adamgreig/rigchip/README.md

# rigchip

connects your CHIP to your RIG

runs off rig 12V, audio in/out, serial in/out, PTT/SQL in/out

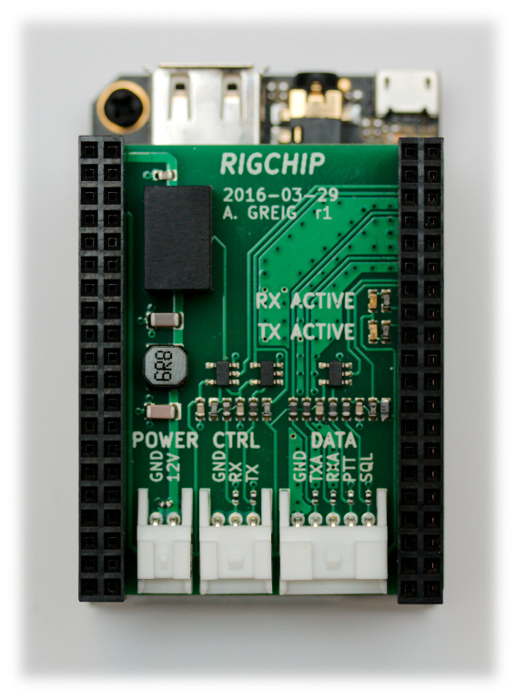
[picture p1: rigchip.jpg]
rigchip glamor shot

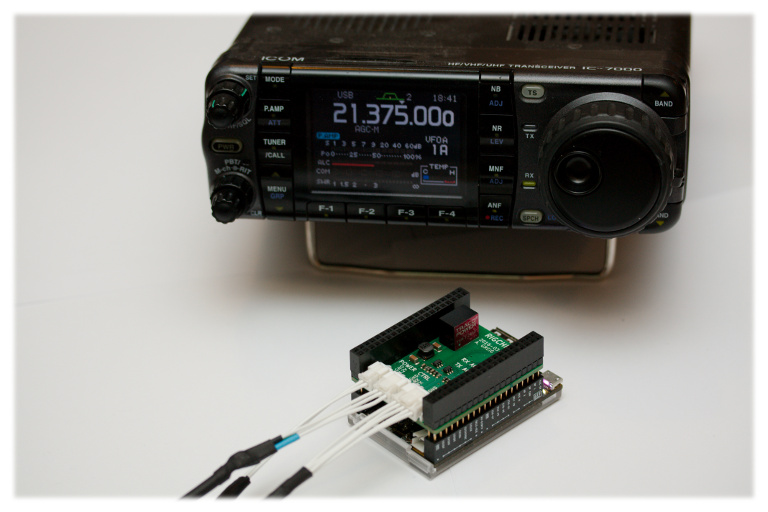
[picture p2: rigchip_with_rig.jpg]
rigchip with rig
