adamgreig/rigchip/pcb/rigchip.png

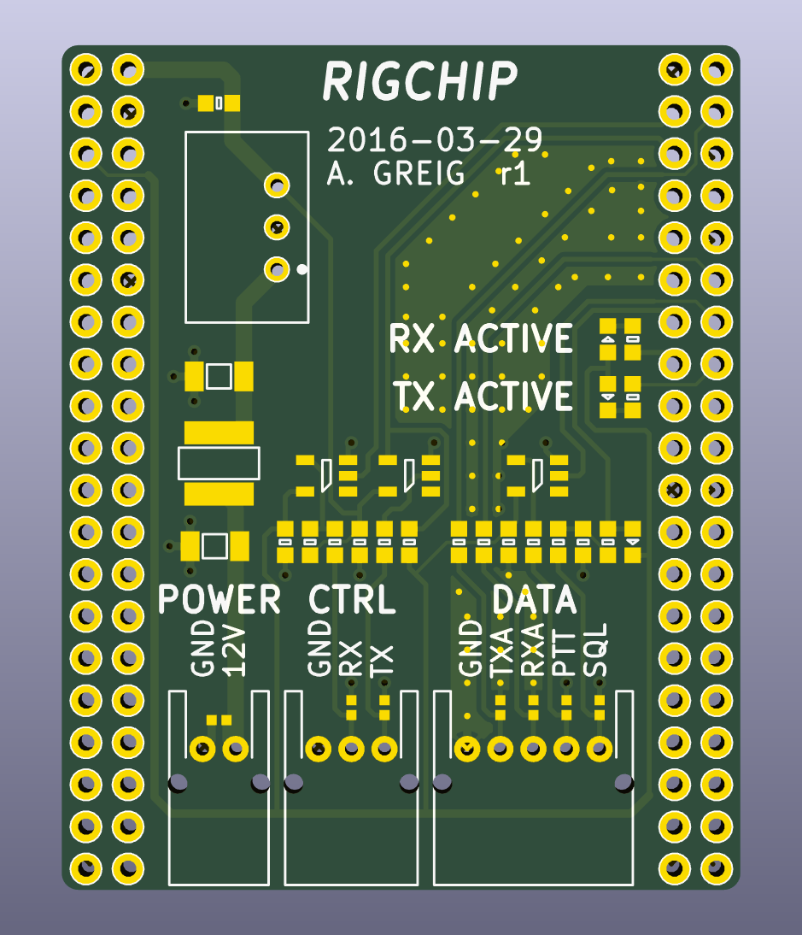
pcb/rigchip.png
