adamgreig/rigchip/pcb/rigchip_bom.pdf

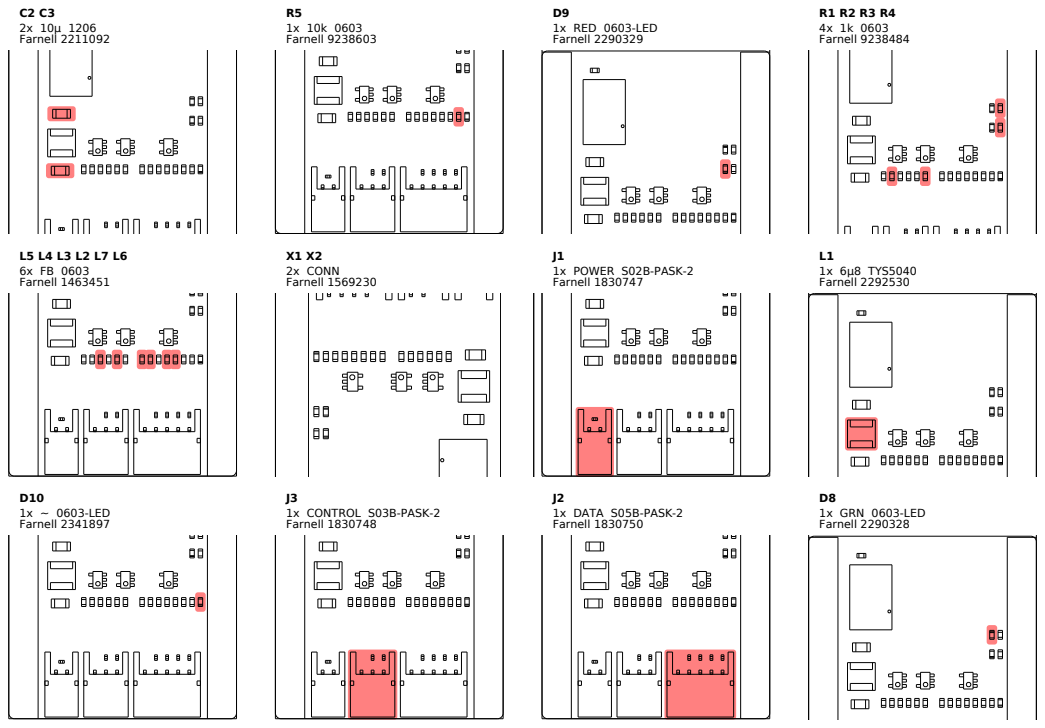
[picture p4: page 1]

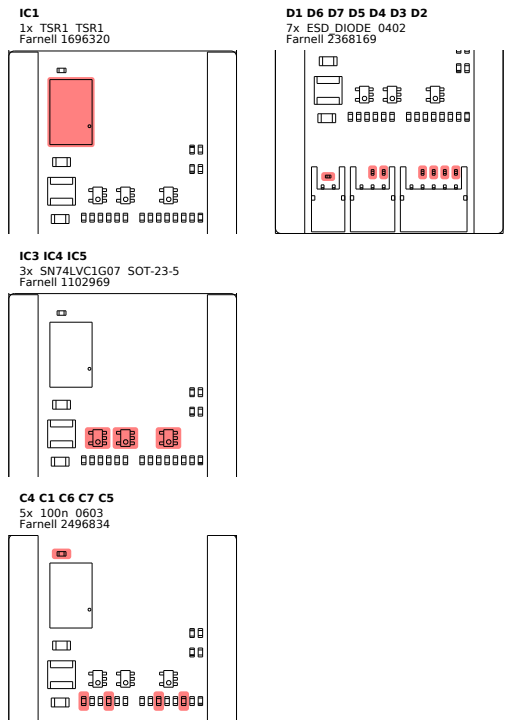
[picture p5: page 2]
