adamgreig/rigchip/pcb/rigchip.pdf

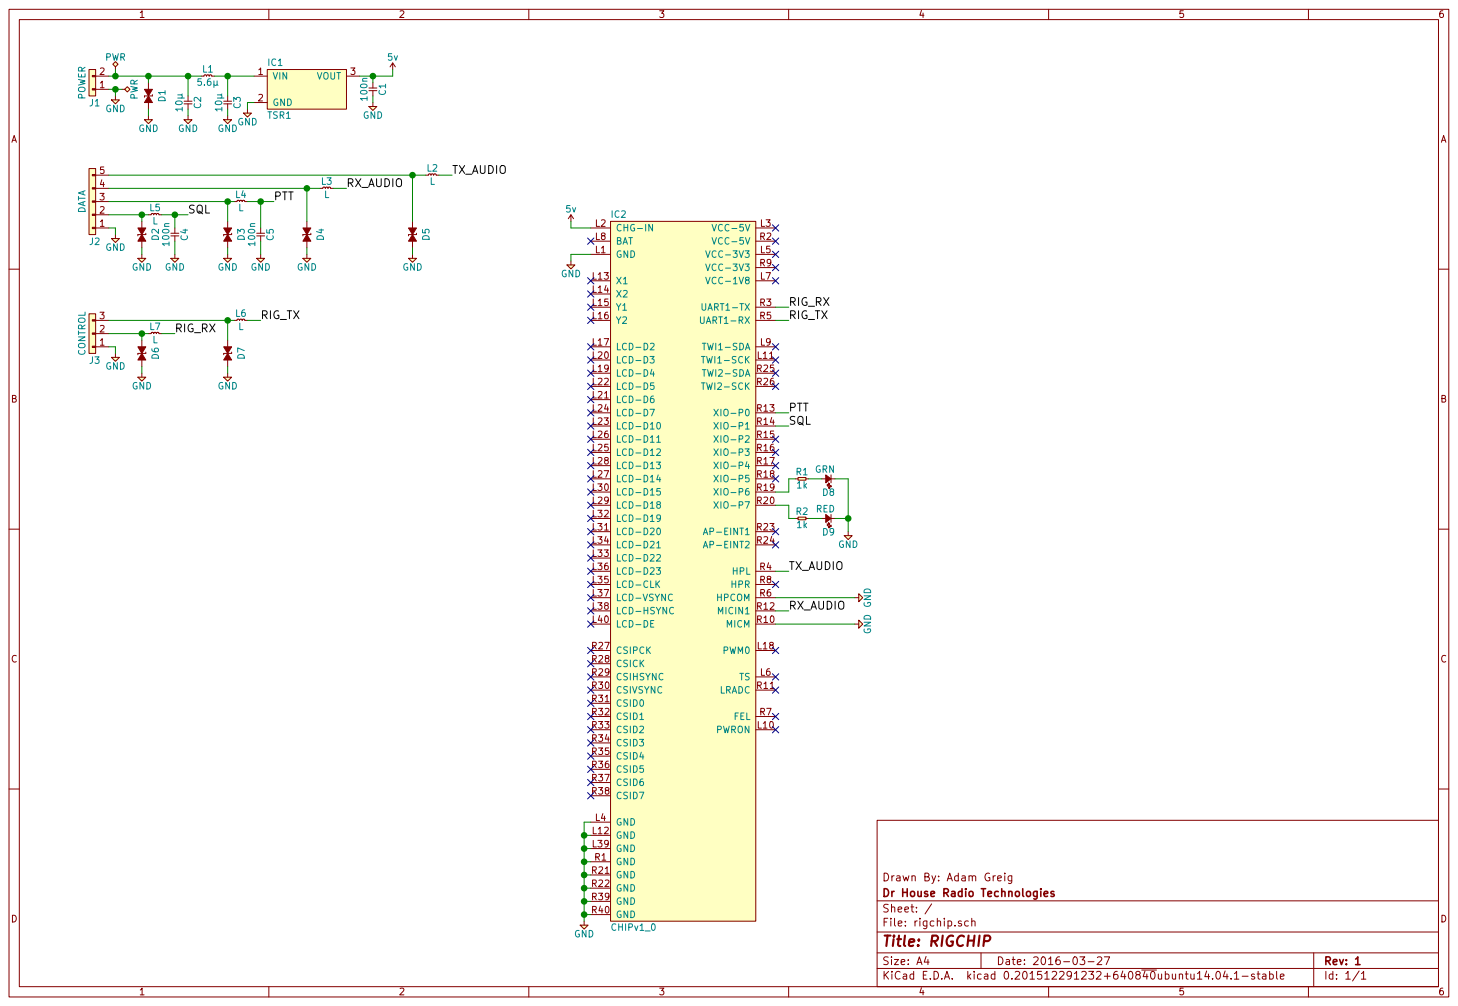
[picture p6: page 1]

Drawn By: Adam Greig
File: rigchip.sch Sheet: / Dr House Radio Technologies
