adamgreig/rigchip/pcb/rigchip.kicad_pcb

## KiCad design pcb/rigchip.kicad_pcb (2016-03-29)

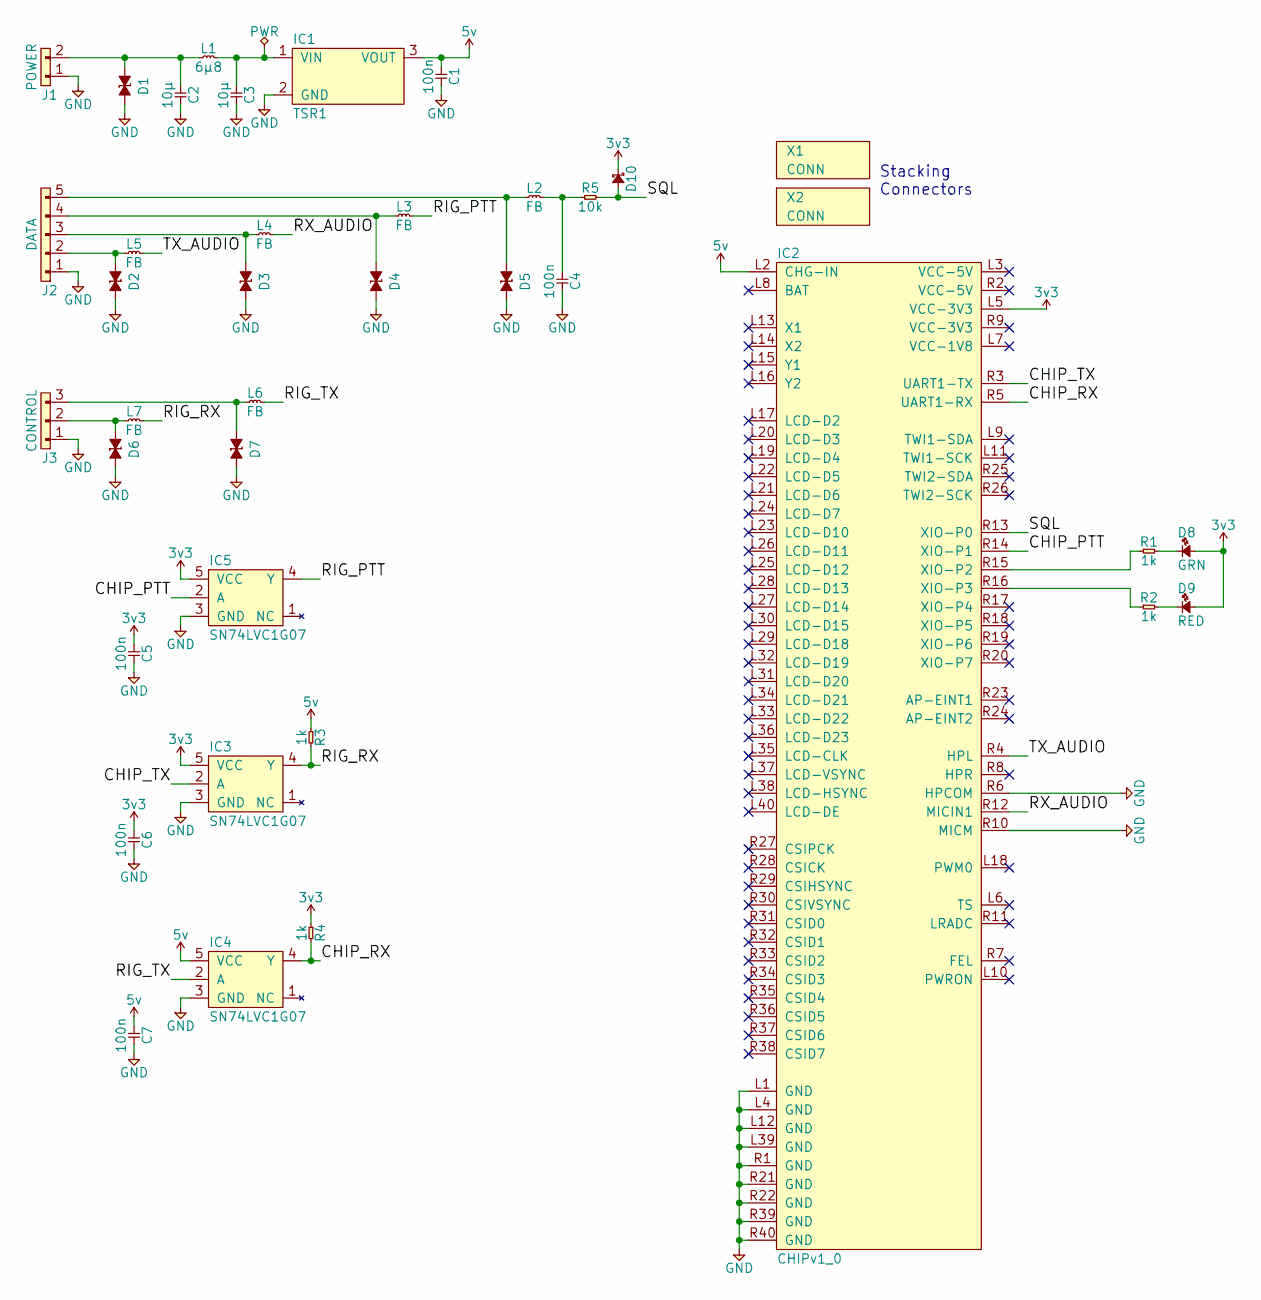
[picture p7: schematic rigchip.sch]

Parts:
C1, C4, C5, C6, C7: 100n; 0603
C2, C3: 10µ; 1206
D1, D2, D3, D4, D5, D6, D7: ESD_DIODE; 0402; Farnell 2368169
D8: GRN; 0603-LED
D9: RED; 0603-LED
D10: 0603-LED
IC1: TSR1; Farnell 1696320
IC2: CHIPv1_0
IC3, IC4, IC5: SN74LVC1G07; SOT-23-5; Farnell 1102969
J1: POWER; S02B-PASK-2
J2: DATA; S05B-PASK-2
J3: CONTROL; S03B-PASK-2
L1: 6µ8; TYS5040; Farnell 2292530
L2, L3, L4, L5, L6, L7: FB; 0603
R1, R2, R3, R4: 1k; 0603
R5: 10k; 0603
X1, X2: CONN; Farnell 1569230

Connections:
3v3: C5.1, C6.1, D8.2, D9.2, D10.1, IC2.L5 (VCC-3V3), IC3.5 (VCC), IC5.5 (VCC), R4.1
5v: C1.1, C7.1, IC1.3 (VOUT), IC2.L2 (CHG-IN), IC4.5 (VCC), R3.1
/CHIP_PTT: IC2.R14 (XIO-P1), IC5.2 (A)
/CHIP_RX: IC2.R5 (UART1-RX), IC4.4 (Y), R4.2
/CHIP_TX: IC2.R3 (UART1-TX), IC3.2 (A)
/RIG_PTT: IC5.4 (Y), L3.2
/RIG_RX: IC3.4 (Y), L7.2, R3.2
/RIG_TX: IC4.2 (A), L6.2
/RX_AUDIO: IC2.R12 (MICIN1), L4.2
/SQL: D10.2, IC2.R13 (XIO-P0), R5.2
/TX_AUDIO: IC2.R4 (HPL), L5.2
GND: C1.2, C2.2, C3.2, C4.2, C5.2, C6.2, C7.2, D1.2, D2.2, D3.2, D4.2, D5.2, D6.2, D7.2, IC1.2 (GND), IC2.L1 (GND), IC2.L4 (GND), IC2.L12 (GND), IC2.L39 (GND), IC2.R1 (GND), IC2.R6 (HPCOM), IC2.R10 (MICM), IC2.R21 (GND), IC2.R22 (GND), IC2.R39 (GND), IC2.R40 (GND), IC3.3 (GND), IC4.3 (GND), IC5.3 (GND), J1.1, J2.1, J3.1
unnamed: C2.1, D1.1, J1.2, L1.1
unnamed: C3.1, IC1.1 (VIN), L1.2
unnamed: C4.1, L2.2, R5.1
unnamed: D2.1, J2.2, L5.1
unnamed: D3.1, J2.3, L4.1
unnamed: D4.1, J2.4, L3.1
unnamed: D5.1, J2.5, L2.1
unnamed: D6.1, J3.2, L7.1
unnamed: D7.1, J3.3, L6.1
unnamed: D8.1, R1.2
unnamed: D9.1, R2.2
unnamed: IC2.R15 (XIO-P2), R1.1
unnamed: IC2.R16 (XIO-P3), R2.1

Notes on the sheet:
Stacking Connectors

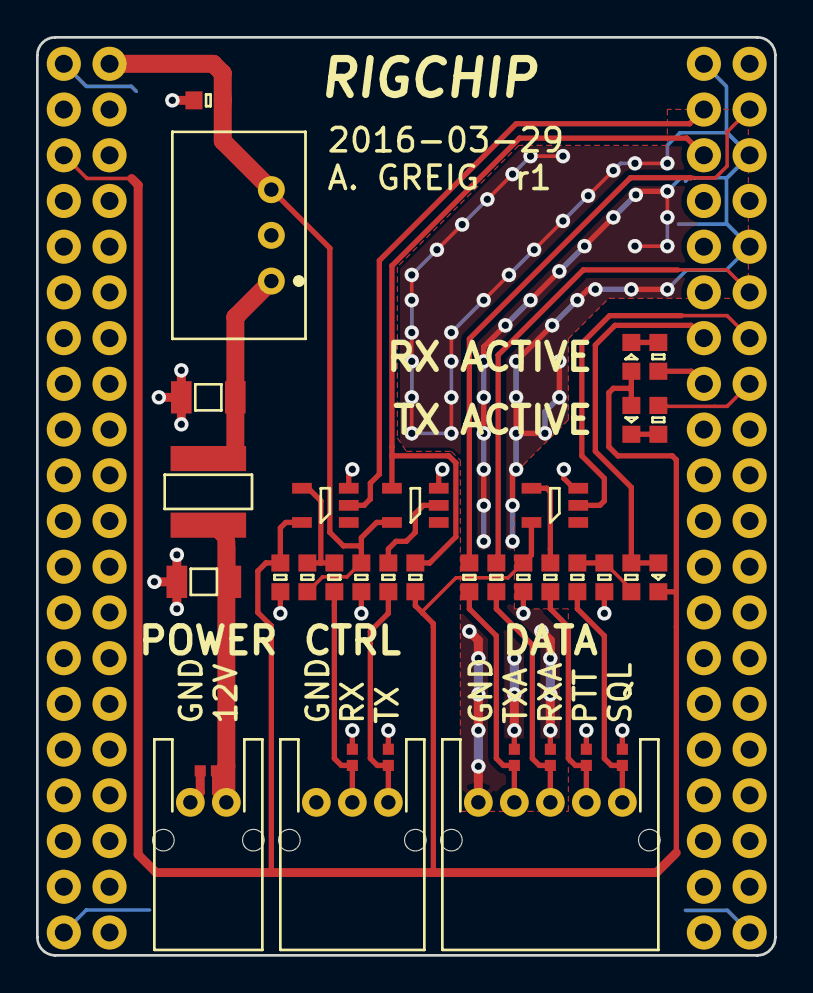
[picture p8: board rigchip.kicad_pcb from above]

Board: 2 copper layers, 41.0 x 51.0 mm, 37 parts (0 on the bottom side), 25 nets.
