adamgreig/rigchip/(commit log)

2016-03-27 add first go at schematic
    [rigchip.kicad_pcb, rigchip.sch]
2016-03-27 first go at routing
    [rigchip-B.Cu.gbl, rigchip-B.Mask.gbs, rigchip-B.SilkS.gbo, rigchip-Edge.Cuts.gm1, rigchip-F.Cu.gtl, rigchip-F.Mask.gts, rigchip-F.SilkS.gto, rigchip-NPTH.drl]
2016-03-27 reroute, no more tracks underneath and nice shielding
    [rigchip-B.Cu.gbl, rigchip-B.Mask.gbs, rigchip-B.SilkS.gbo, rigchip-Edge.Cuts.gm1, rigchip-F.Cu.gtl, rigchip-F.Mask.gts, rigchip-F.SilkS.gto, rigchip-NPTH.drl]
2016-03-27 shrink pcb to header size
    [rigchip-B.Cu.gbl, rigchip-B.Mask.gbs, rigchip-B.SilkS.gbo, rigchip-Edge.Cuts.gm1, rigchip-F.Cu.gtl, rigchip-F.Mask.gts, rigchip-F.SilkS.gto, rigchip-NPTH.drl]
2016-03-27 add buffers to cat control
    [rigchip-B.Cu.gbl, rigchip-B.Mask.gbs, rigchip-B.SilkS.gbo, rigchip-Edge.Cuts.gm1, rigchip-F.Cu.gtl, rigchip-F.Mask.gts, rigchip-F.SilkS.gto, rigchip-NPTH.drl]
2016-03-27 slight reroute of 3v3 net
    [rigchip-B.Cu.gbl, rigchip-B.Mask.gbs, rigchip-B.SilkS.gbo, rigchip-Edge.Cuts.gm1, rigchip-F.Cu.gtl, rigchip-F.Mask.gts, rigchip-F.SilkS.gto, rigchip-NPTH.drl]
2016-03-27 more tweaking
    [rigchip-B.Cu.gbl, rigchip-B.Mask.gbs, rigchip-B.SilkS.gbo, rigchip-Edge.Cuts.gm1, rigchip-F.Cu.gtl, rigchip-F.Mask.gts, rigchip-F.SilkS.gto, rigchip-NPTH.drl]
2016-03-27 add part number for smps
    [rigchip.sch]
2016-03-29 LEDs to sink, driver on PTT, zener+R on SQL, reroute
    [rigchip-B.Cu.gbl, rigchip-B.Mask.gbs, rigchip-B.SilkS.gbo, rigchip-Edge.Cuts.gm1, rigchip-F.Cu.gtl, rigchip-F.Mask.gts, rigchip-F.SilkS.gto, rigchip-NPTH.drl]
2016-03-29 gerbers to manufacturing
2016-03-30 add farnell #s
    [rigchip.sch]
